julian7/cai-274-esphome/hardware/cai-274/cai-274.kicad_sch

## KiCad design hardware/cai-274/cai-274.kicad_sch (2026-10-23)

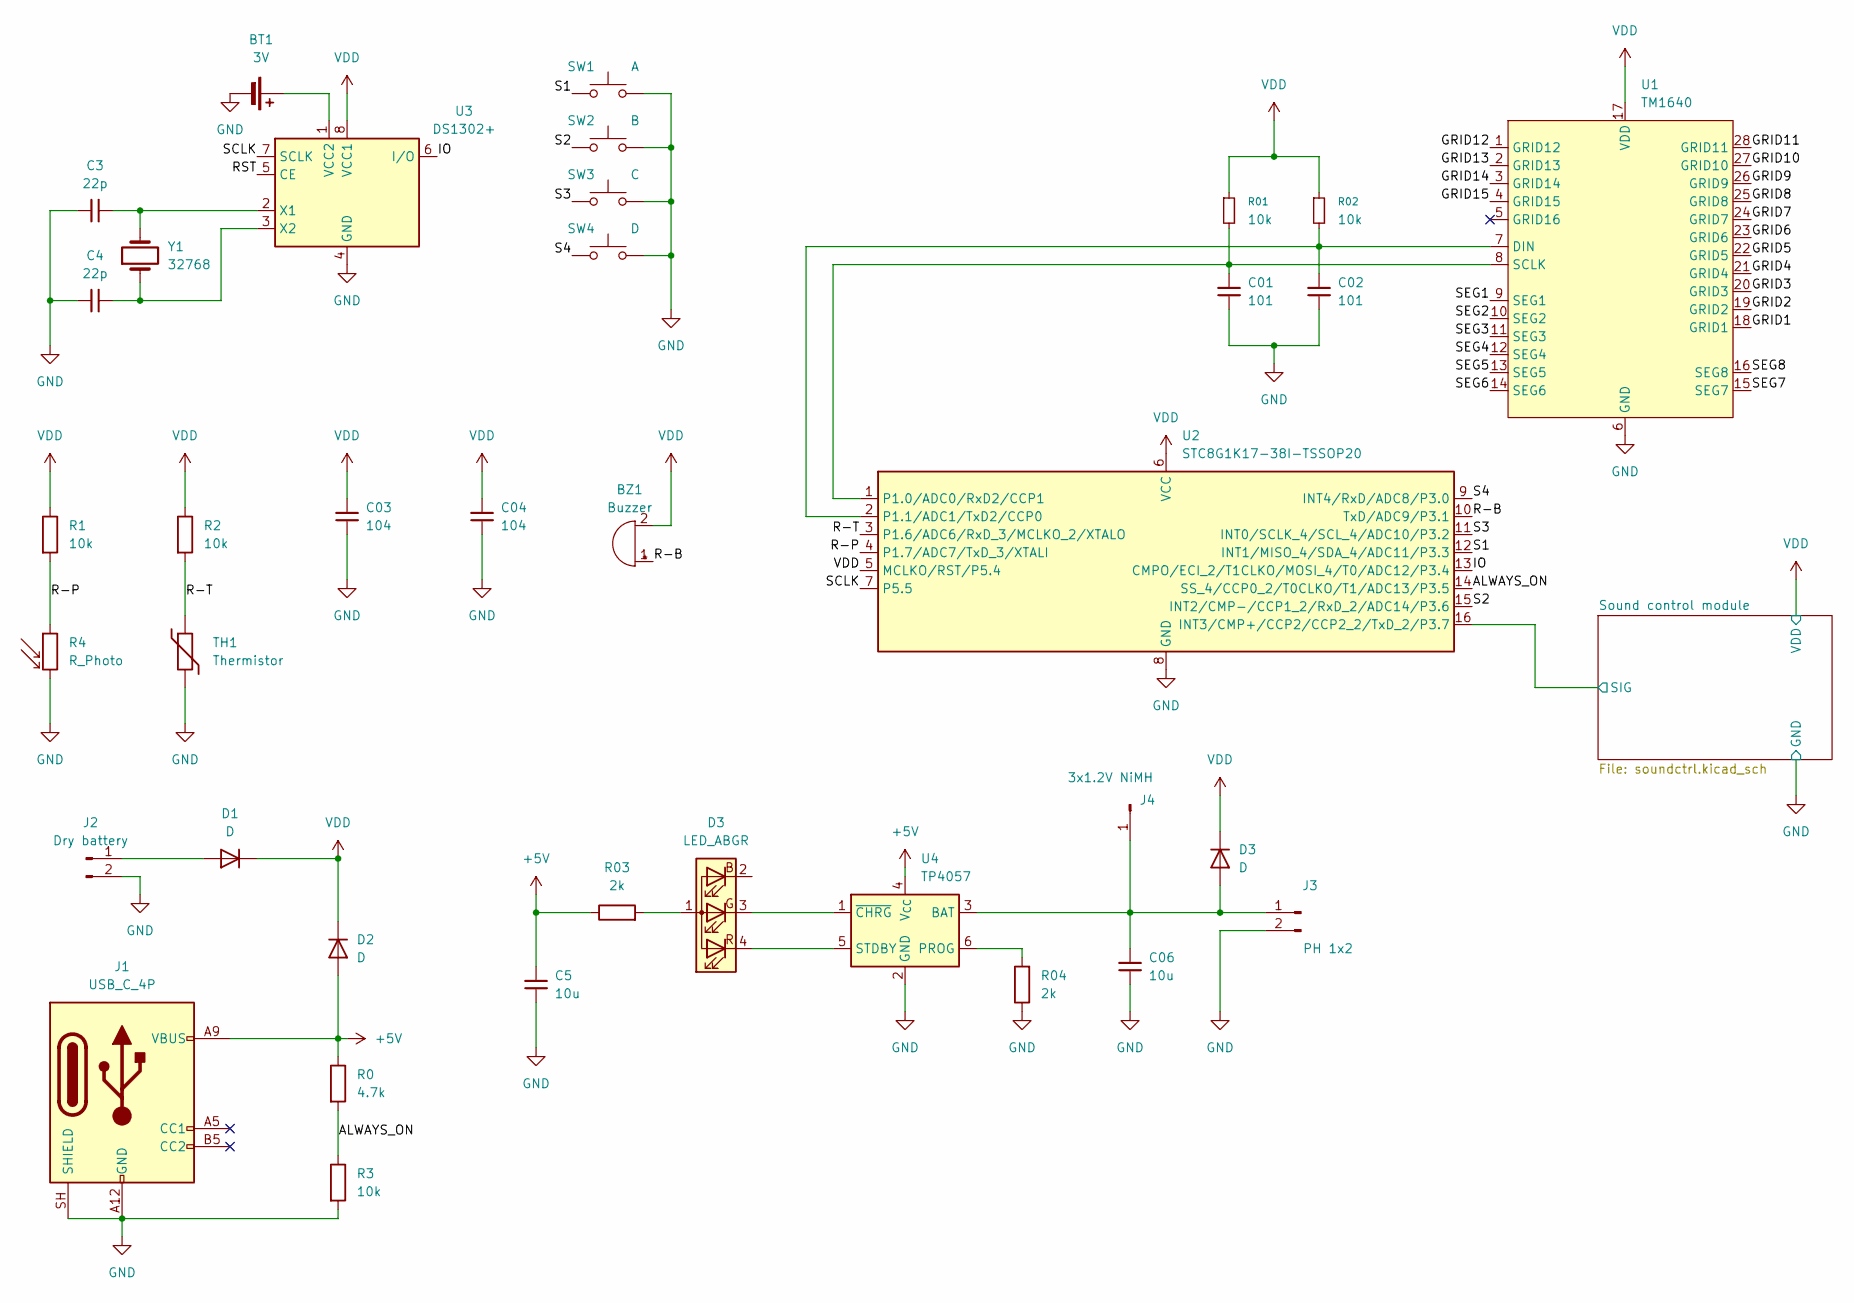
[picture p1: schematic cai-274.kicad_sch]

Parts:
BT1: 3V
BZ1: Buzzer
C01, C02: 101; Xilinx_CSG48_7.0x7.0mm_Layout7x7_P0.8mm
C3, C4: 22p
C03, C04: 104
C5, C06: 10u
D1, D2: D
D3: LED_ABGR
J1: USB_C_4P
J2: Dry battery
J3: PH 1x2; JST_PH_S2B-PH-K_1x02_P2.00mm_Horizontal
J4: 3x1.2V NiMH
R0: 4.7k
R01, R02: 10k; SOIC-28W_7.5x17.9mm_P1.27mm
R1, R2, R3: 10k
R03, R04: 2k
R4: R_Photo; Toshiba_SOIC-4-6_4.4x3.6mm_P1.27mm
SW1: A
SW2: B
SW3: C
SW4: D
TH1: Thermistor; TSSOP-20_4.4x6.5mm_P0.65mm
U1: TM1640; SOIC-28W_7.5x17.9mm_P1.27mm
U2: STC8G1K17-38I-TSSOP20; DIP-16_W10.16mm_LongPads
U3: DS1302+; DIP-8_W7.62mm
U4: TP4057; TSOT-23-6
Y1: 32768

Connections:
+5V: C5.1, D2.2 (A), J1.A9 (VBUS), J1.B9 (VBUS), R0.1, R03.1, U4.4 (V_{CC})
ALWAYS_ON: R0.2, R3.1, U2.14 (SS_4/CCP0_2/T0CLKO/T1/ADC13/P3.5)
GND: BT1.2 (-), C01.2, C02.2, C3.1, C03.2, C4.1, C04.2, C5.2, C06.2, J1.A12 (GND), J1.B12 (GND), J1.SH (SHIELD), J2.2, J3.2, R3.2, R04.1, R4.2, SW1.2, SW2.2, SW3.2, SW4.2, TH1.2, U1.6 (GND), U2.8 (GND), U3.4 (GND), U4.2 (GND)
GRID1: U1.18 (GRID1)
GRID2: U1.19 (GRID2)
GRID3: U1.20 (GRID3)
GRID4: U1.21 (GRID4)
GRID5: U1.22 (GRID5)
GRID6: U1.23 (GRID6)
GRID7: U1.24 (GRID7)
GRID8: U1.25 (GRID8)
GRID9: U1.26 (GRID9)
GRID10: U1.27 (GRID10)
GRID11: U1.28 (GRID11)
GRID12: U1.1 (GRID12)
GRID13: U1.2 (GRID13)
GRID14: U1.3 (GRID14)
GRID15: U1.4 (GRID15)
IO: U2.13 (CMPO/ECI_2/T1CLKO/MOSI_4/T0/ADC12/P3.4), U3.6 (I/O)
unnamed: BT1.1 (+), U3.1 (VCC2)
unnamed: C01.1, R01.2, U1.8 (SCLK), U2.1 (P1.0/ADC0/RxD2/CCP1)
unnamed: C02.1, R02.2, U1.7 (DIN), U2.2 (P1.1/ADC1/TxD2/CCP0)
unnamed: C3.2, U3.2 (X1), Y1.2
unnamed: C4.2, U3.3 (X2), Y1.1
unnamed: C06.1, D3.2 (A), J3.1, J4.1, U4.3 (BAT)
unnamed: D1.2 (A), J2.1
unnamed: D3.1 (K), R03.2
unnamed: D3.3 (GK), U4.1 (~CHRG)
unnamed: D3.4 (RK), U4.5 (STDBY)
unnamed: R04.2, U4.6 (PROG)
R-B: BZ1.1 (+), U2.10 (TxD/ADC9/P3.1)
R-P: R1.2, R4.1, U2.4 (P1.7/ADC7/TxD_3/XTALI)
R-T: R2.2, TH1.1, U2.3 (P1.6/ADC6/RxD_3/MCLKO_2/XTALO)
RST: U3.5 (CE)
S1: SW1.1, U2.12 (INT1/MISO_4/SDA_4/ADC11/P3.3)
S2: SW2.1, U2.15 (INT2/CMP-/CCP1_2/RxD_2/ADC14/P3.6)
S3: SW3.1, U2.11 (INT0/SCLK_4/SCL_4/ADC10/P3.2)
S4: SW4.1, U2.9 (INT4/RxD/ADC8/P3.0)
SCLK: U2.7 (P5.5), U3.7 (SCLK)
SEG1: U1.9 (SEG1)
SEG2: U1.10 (SEG2)
SEG3: U1.11 (SEG3)
SEG4: U1.12 (SEG4)
SEG5: U1.13 (SEG5)
SEG6: U1.14 (SEG6)
SEG7: U1.15 (SEG7)
SEG8: U1.16 (SEG8)
SIG: U2.16 (INT3/CMP+/CCP2/CCP2_2/TxD_2/P3.7)
VDD: BZ1.2 (-), C03.1, C04.1, D1.1 (K), D2.1 (K), D3.1 (K), R01.1, R1.1, R02.1, R2.1, U1.17 (VDD), U2.5 (MCLKO/RST/P5.4), U2.6 (VCC), U3.8 (VCC1)
