julian7/cai-274-esphome/hardware/cai-274/soundctrl.kicad_sch

## KiCad design hardware/cai-274/soundctrl.kicad_sch (2026-10-23)

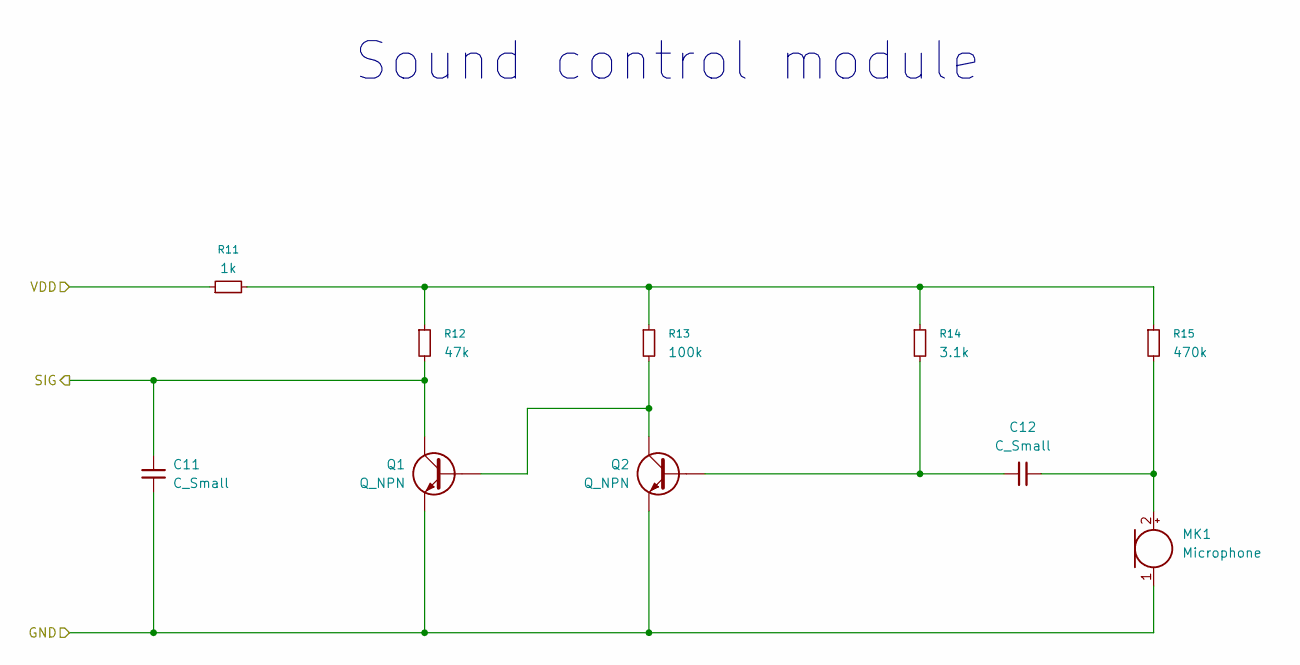
[picture p2: schematic soundctrl.kicad_sch]

Parts:
C11, C12: C_Small
MK1: Microphone
Q1, Q2: Q_NPN
R11: 1k
R12: 47k
R13: 100k
R14: 3.1k
R15: 470k

Connections:
GND: C11.2, MK1.1 (-), Q1.E, Q2.E
unnamed: C12.1, Q2.B, R14.2
unnamed: C12.2, MK1.2 (+), R15.2
unnamed: Q1.B, Q2.C, R13.2
unnamed: R11.2, R12.1, R13.1, R14.1, R15.1
SIG: C11.1, Q1.C, R12.2
VDD: R11.1

Notes on the sheet:
Sound control module
